adafruit/Adafruit-MacroPad-RP2040-PCB/Adafruit MacroPad 2040 rev D.sch

## EAGLE design Adafruit MacroPad 2040 rev D.sch (2024-06-27)

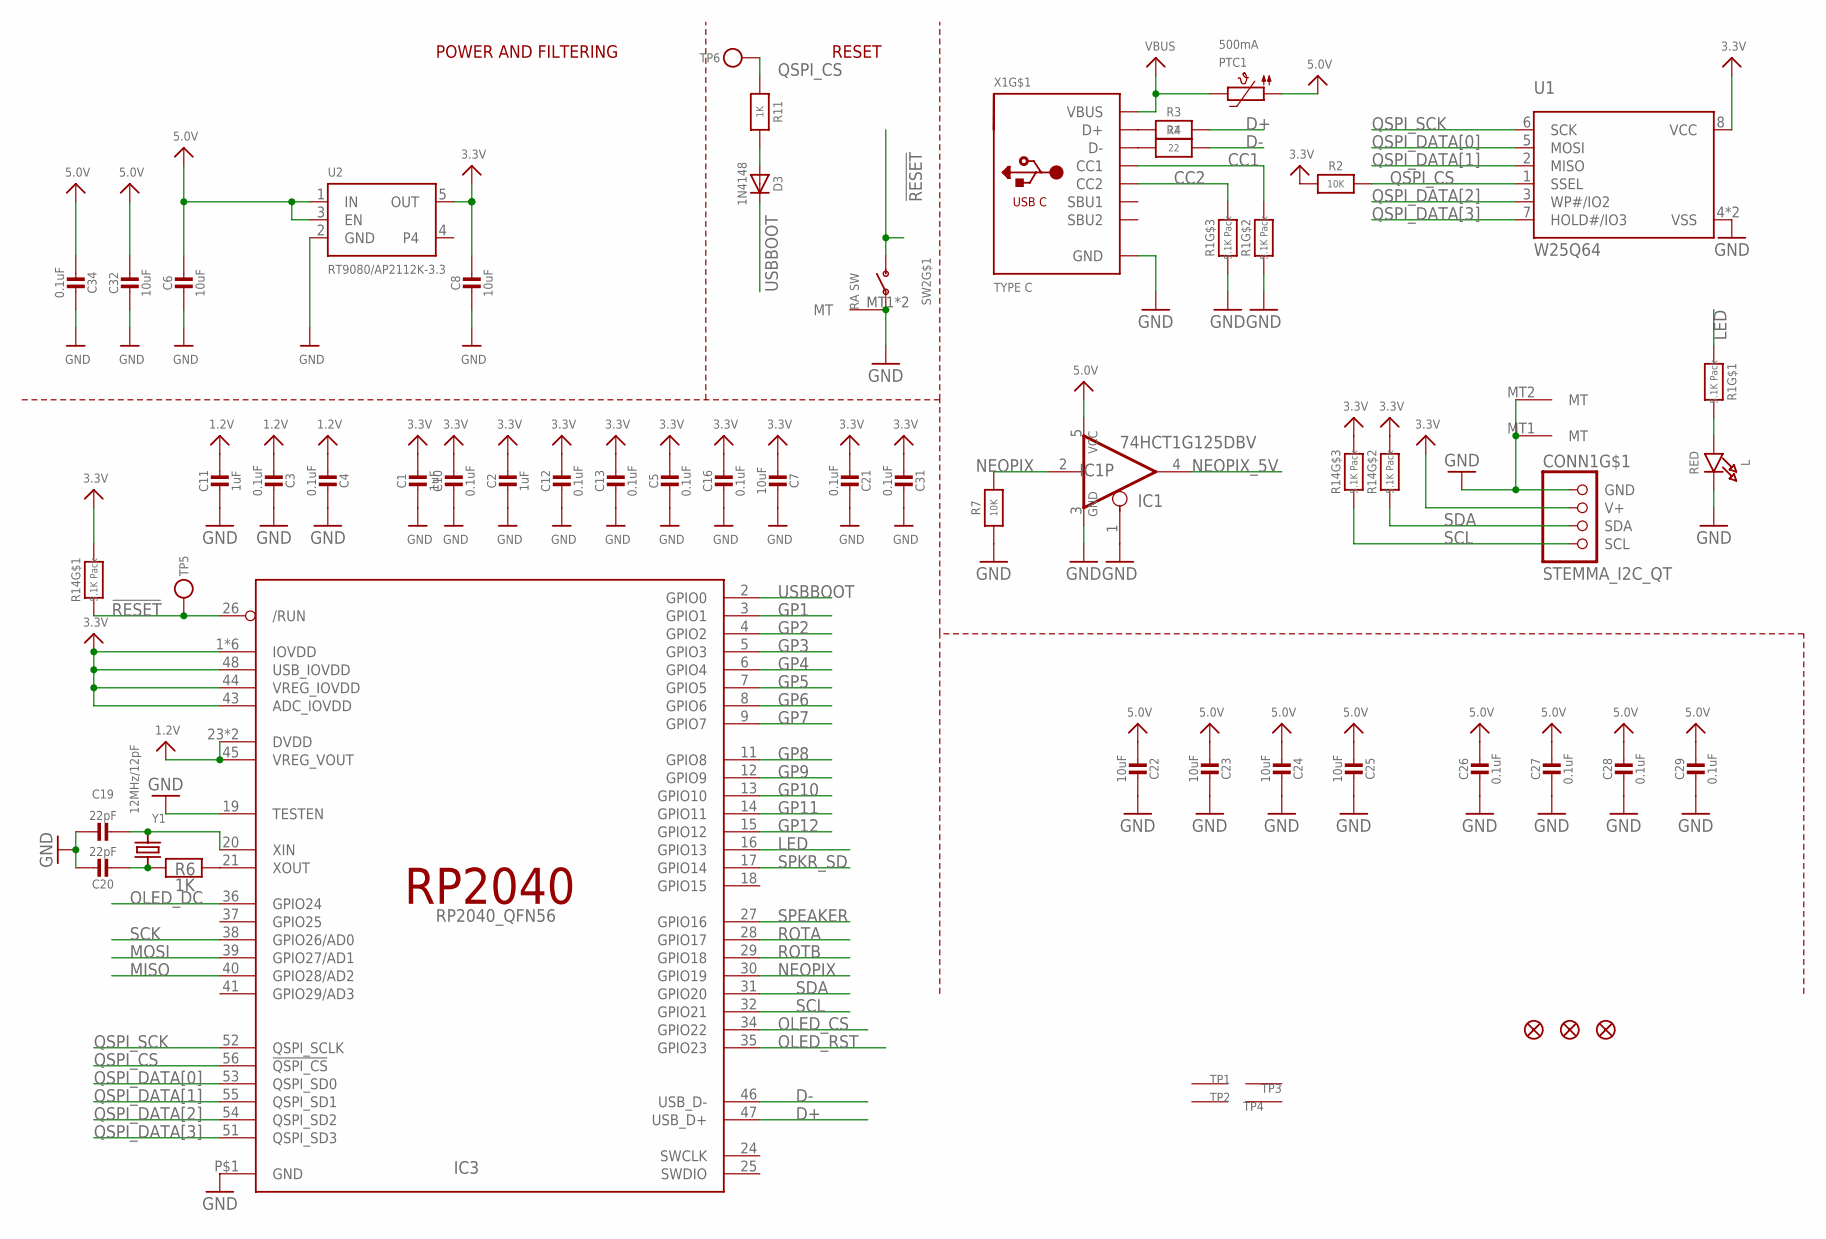
[picture p2: schematic Adafruit MacroPad 2040 rev D.sch, sheet 1]

Parts:
C1, C2, C11: 1uF; 0603-NO
C3, C4, C5, C10, C12, C13, C16, C21, C26, C27, C28, C29, C31, C34: 0.1uF; 0603-NO
C6, C7, C8, C22, C23, C24, C25, C32: 10uF; 0805-NO
C19, C20: 22pF; 0603-NO
CONN1: STEMMA_I2C_QT; JST_SH4
D3: 1N4148; SOD-323
IC1: 74HCT1G125DBV; SOT23-5
IC3: RP2040_QFN56; QFN56_7MM_REDUCEDEPAD
L: RED; CHIPLED_0603_NOOUTLINE
PTC1: 500mA; 0805-NO
R1, R14: 5.1K Pack; RESPACK_4X0603
R2, R7: 10K; 0603-NO
R3, R4: 22; 0603-NO
R6, R11: 1K; 0603-NO
SW2: RA SW; SPST_TACTILE_RA
TP1, TP2, TP3, TP4: SEWTAP_SMTNUTM3; SMT_NUT_3MM
TP5, TP6: TESTPOINTROUND1.5MMNO; TESTPOINT_ROUND_1.5MM_NO
U1: W25Q64; USON8_4X4
U2: RT9080/AP2112K-3.3; SOT23-5; JLC_ROTATION 0
U$34, U$35, U$80: FIDUCIAL_1MM
X1: TYPE C; USB_C_CUSB31-CFM2AX-01-X
Y1: 12MHz/12pF; CRYSTAL_2.5X2

Connections:
1.2V: C3.2, C4.2, C11.1, IC3.23 (DVDD), IC3.45 (VREG_VOUT)
3.3V: C1.1, C2.1, C5.1, C7.2, C8.1, C10.1, C12.1, C13.1, C16.1, C21.2, C31.2, CONN1.2 (V+), IC3.1 (IOVDD), IC3.43 (ADC_IOVDD), IC3.44 (VREG_IOVDD), IC3.48 (USB_IOVDD), R2.1, R14.6 (2), R14.7 (2), R14.8 (2), U1.8 (VCC), U2.5 (OUT)
5.0V: C6.1, C22.2, C23.2, C24.2, C25.2, C26.1, C27.1, C28.1, C29.1, C32.1, C34.2, IC1.5 (VCC), PTC1.1, U2.1 (IN), U2.3 (EN)
!RESET: IC3.26 (/RUN), R14.1, SW2.2 (S), TP5.P$1
CC1: R1.7 (2), X1.A5 (CC1)
CC2: R1.6 (2), X1.B5 (CC2)
D+: IC3.47 (USB_D+), R3.2
D-: IC3.46 (USB_D-), R4.2
GND: C1.2, C2.2, C3.1, C4.1, C5.2, C6.2, C7.1, C8.2, C10.2, C11.2, C12.2, C13.2, C16.2, C19.1, C20.1, C21.1, C22.1, C23.1, C24.1, C25.1, C26.2, C27.2, C28.2, C29.2, C31.1, C32.2, C34.1, CONN1.1 (GND), CONN1.MT1 (MT), CONN1.MT2 (MT), IC1.1 (OE), IC1.3 (GND), IC3.19 (TESTEN), IC3.P$1 (GND), L.C, R1.2 (1), R1.3 (1), R7.1, SW2.1, SW2.MT1 (MT), U1.4 (VSS), U2.2 (GND), X1.A1B12 (GND)
GP1: IC3.3 (GPIO1)
GP2: IC3.4 (GPIO2)
GP3: IC3.5 (GPIO3)
GP4: IC3.6 (GPIO4)
GP5: IC3.7 (GPIO5)
GP6: IC3.8 (GPIO6)
GP7: IC3.9 (GPIO7)
GP8: IC3.11 (GPIO8)
GP9: IC3.12 (GPIO9)
GP10: IC3.13 (GPIO10)
GP11: IC3.14 (GPIO11)
GP12: IC3.15 (GPIO12)
LED: IC3.16 (GPIO13), R1.1
MISO: IC3.40 (GPIO28/AD2)
MOSI: IC3.39 (GPIO27/AD1)
unnamed: R3.1, X1.A6 (D+)
unnamed: L.A, R1.8 (2)
unnamed: R4.1, X1.A7 (D-)
unnamed: D3.A, R11.2
unnamed: C19.2, IC3.20 (XIN), Y1.3 (2)
unnamed: C20.2, R6.1, Y1.1
unnamed: IC3.21 (XOUT), R6.2
NEOPIX: IC1.2 (I), IC3.30 (GPIO19), R7.2
NEOPIX_5V: IC1.4 (O)
OLED_CS: IC3.34 (GPIO22)
OLED_DC: IC3.36 (GPIO24)
OLED_RST: IC3.35 (GPIO23)
QSPI_CS: IC3.56 (!QSPI_CS), R2.2, R11.1, TP6.P$1, U1.1 (SSEL)
QSPI_DATA[0]: IC3.53 (QSPI_SD0), U1.5 (MOSI)
QSPI_DATA[1]: IC3.55 (QSPI_SD1), U1.2 (MISO)
QSPI_DATA[2]: IC3.54 (QSPI_SD2), U1.3 (WP#/IO2)
QSPI_DATA[3]: IC3.51 (QSPI_SD3), U1.7 (HOLD#/IO3)
QSPI_SCK: IC3.52 (QSPI_SCLK), U1.6 (SCK)
ROTA: IC3.28 (GPIO17)
ROTB: IC3.29 (GPIO18)
SCK: IC3.38 (GPIO26/AD0)
SCL: CONN1.4 (SCL), IC3.32 (GPIO21), R14.3 (1)
SDA: CONN1.3 (SDA), IC3.31 (GPIO20), R14.2 (1)
SPEAKER: IC3.27 (GPIO16)
SPKR_SD: IC3.17 (GPIO14)
USBBOOT: D3.C, IC3.2 (GPIO0)
VBUS: PTC1.2, X1.A4B9 (VBUS)

Notes on the sheet:
POWER AND FILTERING
RESET

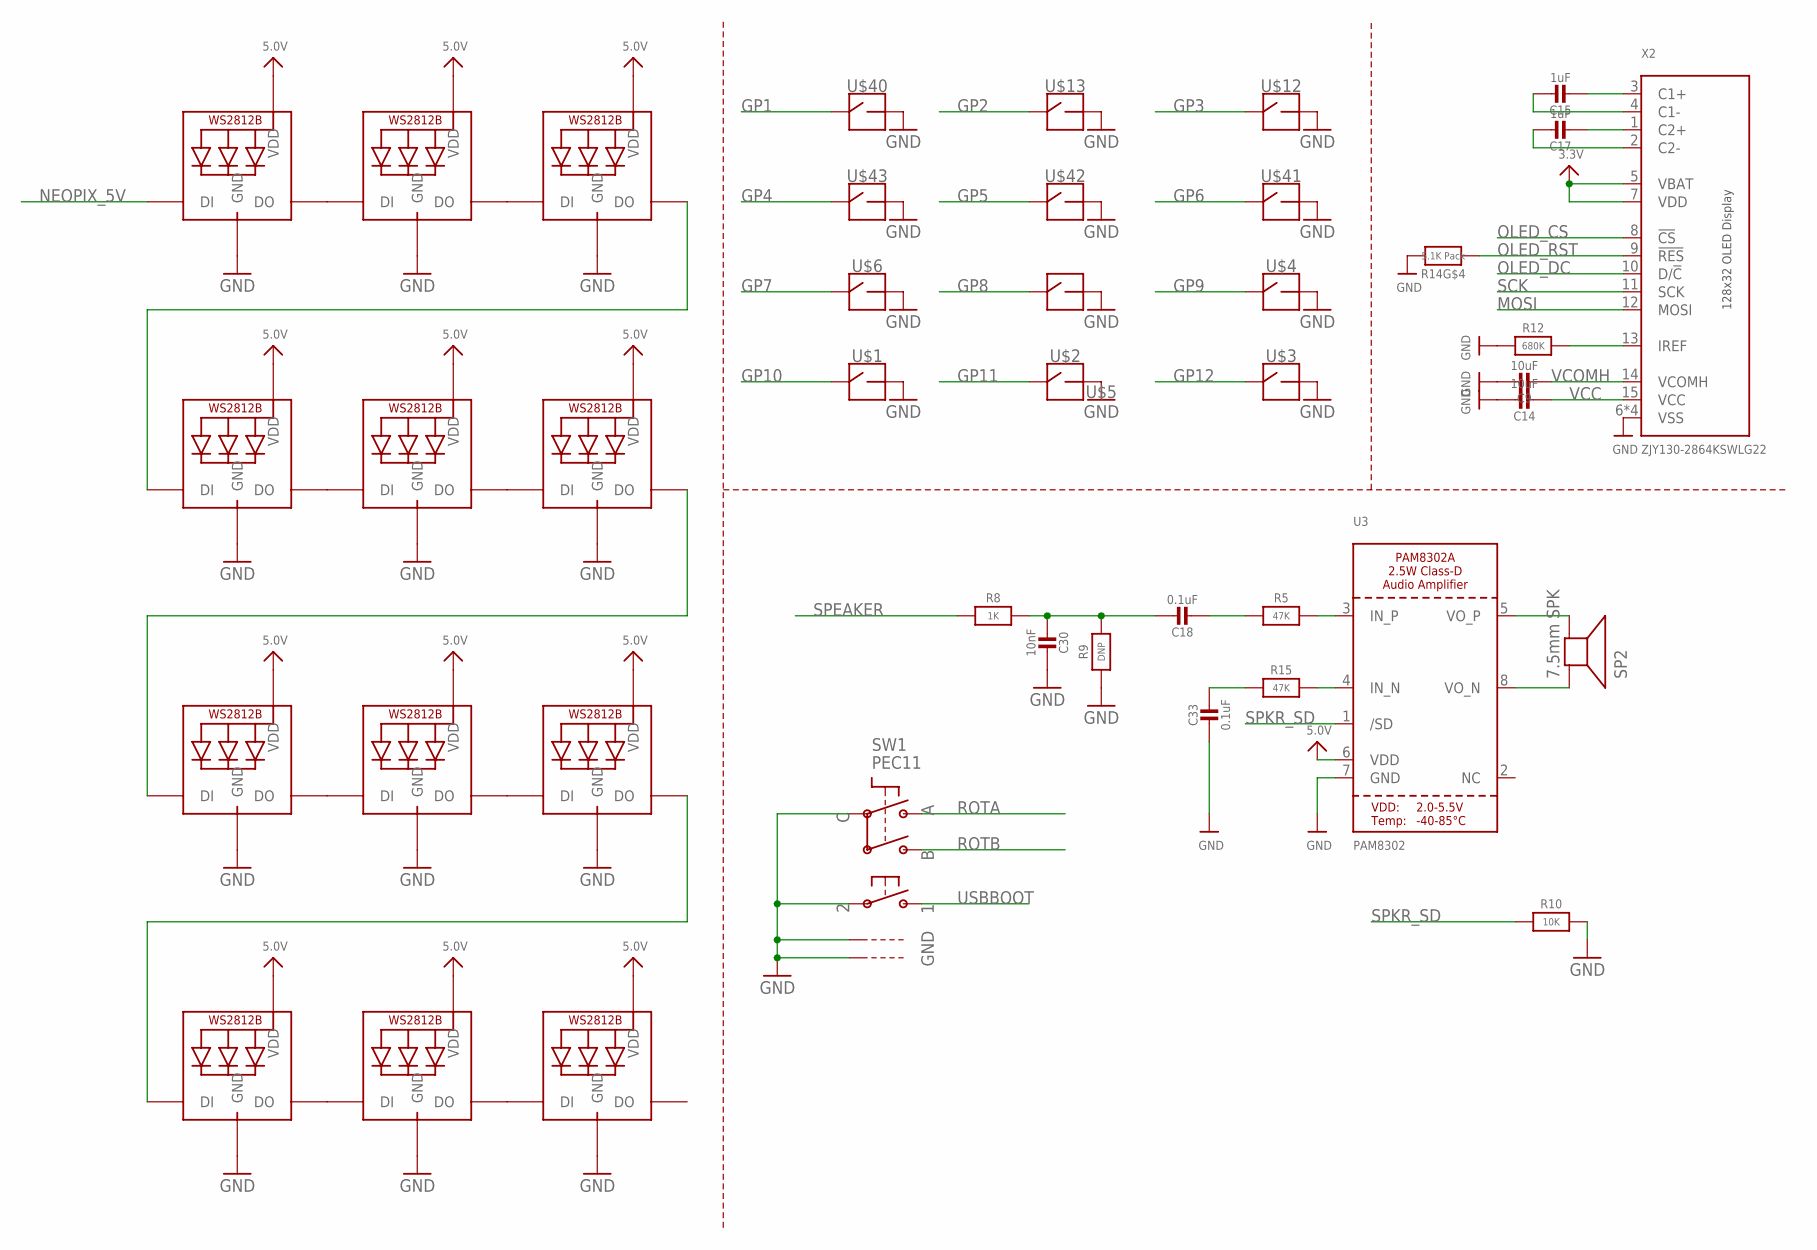
[picture p3: schematic Adafruit MacroPad 2040 rev D.sch, sheet 2]

Parts:
C9, C14: 10uF; 0805-NO
C15, C17: 1uF; 0603-NO
C18, C33: 0.1uF; 0603-NO
C30: 10nF; 0603-NO
LED1, LED2, LED3, LED4, LED5, LED6, LED7, LED8, LED9, LED10, LED11, LED12: WS2812B_SK6812E; NEO3535_REVERSE
R5, R15: 47K; 0603-NO
R8: 1K; 0603-NO
R9: DNP; 0603-NO
R10: 10K; 0603-NO
R12: 680K; 0603-NO
R14: 5.1K Pack; RESPACK_4X0603
SP2: 7.5mm SPK; BUZZER_SMT_7.5MM
SW1: PEC11; PEC11_SW_FIXED
U3: PAM8302; MSOP8_0.65MM
U$1, U$2, U$3, U$4, U$5, U$6, U$12, U$13, U$40, U$41, U$42, U$43: SOCKET; KAILH_SOCKET
X2: ZJY130-2864KSWLG22

Connections:
3.3V: X2.5 (VBAT), X2.7 (VDD)
5.0V: LED1.1-VDD (VDD), LED2.1-VDD (VDD), LED3.1-VDD (VDD), LED4.1-VDD (VDD), LED5.1-VDD (VDD), LED6.1-VDD (VDD), LED7.1-VDD (VDD), LED8.1-VDD (VDD), LED9.1-VDD (VDD), LED10.1-VDD (VDD), LED11.1-VDD (VDD), LED12.1-VDD (VDD), U3.6 (VDD)
GND: C9.1, C14.1, C30.1, C33.2, LED1.3-GND (GND), LED2.3-GND (GND), LED3.3-GND (GND), LED4.3-GND (GND), LED5.3-GND (GND), LED6.3-GND (GND), LED7.3-GND (GND), LED8.3-GND (GND), LED9.3-GND (GND), LED10.3-GND (GND), LED11.3-GND (GND), LED12.3-GND (GND), R9.1, R10.2, R12.1, R14.5 (2), SW1.P$2, SW1.P$C, SW1.P$GND1, SW1.P$GND2, U3.7 (GND), U$1.2, U$2.2, U$3.2, U$4.2, U$5.2, U$6.2, U$12.2, U$13.2, U$40.2, U$41.2, U$42.2, U$43.2, X2.6 (VSS)
GP1: U$40.1
GP2: U$13.1
GP3: U$12.1
GP4: U$43.1
GP5: U$42.1
GP6: U$41.1
GP7: U$6.1
GP8: U$5.1
GP9: U$4.1
GP10: U$1.1
GP11: U$2.1
GP12: U$3.1
IN+: R5.2, U3.3 (IN_P)
IN-: R15.2, U3.4 (IN_N)
MOSI: X2.12 (MOSI)
unnamed: C18.2, R5.1
unnamed: LED1.2-DOUT (DO), LED2.4-DIN (DI)
unnamed: LED2.2-DOUT (DO), LED3.4-DIN (DI)
unnamed: LED4.2-DOUT (DO), LED5.4-DIN (DI)
unnamed: LED5.2-DOUT (DO), LED6.4-DIN (DI)
unnamed: LED7.2-DOUT (DO), LED8.4-DIN (DI)
unnamed: LED8.2-DOUT (DO), LED9.4-DIN (DI)
unnamed: LED10.2-DOUT (DO), LED11.4-DIN (DI)
unnamed: LED11.2-DOUT (DO), LED12.4-DIN (DI)
unnamed: LED3.2-DOUT (DO), LED4.4-DIN (DI)
unnamed: LED6.2-DOUT (DO), LED7.4-DIN (DI)
unnamed: LED9.2-DOUT (DO), LED10.4-DIN (DI)
unnamed: R12.2, X2.13 (IREF)
unnamed: SP2.-, U3.5 (VO_P)
unnamed: C17.1, X2.2 (C2-)
unnamed: C17.2, X2.1 (C2+)
unnamed: C15.1, X2.4 (C1-)
unnamed: C15.2, X2.3 (C1+)
unnamed: SP2.+, U3.8 (VO_N)
unnamed: C33.1, R15.1
unnamed: C18.1, C30.2, R8.2, R9.2
NEOPIX_5V: LED1.4-DIN (DI)
OLED_CS: X2.8 (!CS)
OLED_DC: X2.10 (D/!C)
OLED_RST: R14.4 (1), X2.9 (!RES)
ROTA: SW1.P$A
ROTB: SW1.P$B
SCK: X2.11 (SCK)
SPEAKER: R8.1
SPKR_SD: R10.1, U3.1 (/SD)
USBBOOT: SW1.P$1
VCC: C14.2, X2.15 (VCC)
VCOMH: C9.2, X2.14 (VCOMH)
