adafruit/Adafruit-MacroPad-RP2040-PCB/(threads)

Thread 1 (2021-08-22):

MacroPad I2C pinout diagram (not schematic) has wrong pinout.

derekmulcahy, 2021-08-22:
The pinout for the I2C connector is wrong on the diagram!

The pinout order is the same as the FunHouse, from the top SCL/SDA/3.3V/GND.

caternuson, 2021-08-22:
On the Macropad, the connector is on the front/right side of the PCB. On the FunHouse, the connector is on the back/left side of the PCB. The combination of the two makes the pads end up in the same physical arrangement when viewed in the PCB layout.

derekmulcahy, 2021-08-22:
But this diagram gives the impression that GND is at the top of the connector, it is at the bottom.

https://github.com/adafruit/Adafruit-MacroPad-RP2040-PCB/blob/main/Adafruit%20MacroPad%20RP2040%20Pinout.pdf

caternuson, 2021-08-22:
Thanks for clarifying. That document does look incorrect.

@kattni Hey, can you take a look? Might have something to do with the "front" of the PCB actually being the "back" of the MacroPad (as used).

dhalbert, 2021-08-22:
If I just plug in a STEMMA/QT cable to the MacroPad, it is yellow-blue-red-back top to bottom. So the diagram is upside down for that connector.

kattni, 2021-08-23:
Thank you for catching this. The connector was reversed on the Fritzing object, which is used for the basis of the PrettyPins images. I have updated the PrettyPins images and the Fritzing object to the appropriate order.

Closed 2021-08-23.

Thread 2 (2024-06-26):

Update schematics and board to Rev D

dhalbert, 2024-06-26:
A discord user asked for this, to see the revised audio amplifier.

@ladyada

ladyada, 2024-06-26:
@BlitzCityDIY no rush, can you add?

BlitzCityDIY, 2024-06-27:
added!

jasonj2232, 2024-06-27:
Hi! I am the discord user who had requested for these files. I would just like to thank you all for responding so quickly and for being an awesome bunch of people! Thank you so much!

Closed 2024-06-27.
