adafruit/Adafruit-MacroPad-RP2040-PCB/(commit log)

2021-06-30 Add board files.
    [Adafruit MacroPad 2040.sch]
2024-06-27 adding new eagle files
    [Adafruit MacroPad 2040 rev D.sch]
